mofeomolade/6S-LiPo-Buck/5V_Buck_Converter.asc

C1: cap; 2.2µF
C2: cap; 3nF
C3: cap; 0.22µ; V=50 Irms=0 Rser=0 Lser=0 mfg="Murata" pn="GCM188R71H224KA64" type="X7R"
C4: polcap; 820µ; V=35 Irms=1.045 Rser=0.081 Lser=25.9n mfg="Würth Elektronik" pn="860010578016 WCAP-ATG8 13x20" type="Al electrolytic"
C5: cap; 22µ; V=35 Irms=2.1 Rser=0.0099 Lser=3.273n mfg="Würth Elektronik" pn="870055673002 WCAP-PTHR 6,3 x 8" type="Al polymer"
C6: cap; 18nF
C7: cap; 10nF
C8: cap; 270nF
C9: cap; 1µF
D1: diode; DDZ9684
D2: schottky; MBRS360
D3: schottky; MBRS360
I1: current; 0.9ma
L2: ind; 470µ; Ipk=3.4 Rser=0.0105 Rpar=44274 Cpar=0 mfg="Coilcraft" pn="AGP4233-474"
M2: nmos; IRF530
R1: res; 10k
R2: res; 20
R3: res; 10
R4: res; 10k
R5: res; 390
R6: res; 10k
R7: res; 750
R8: res; 10k
R9: res; 10k
R10: res; 100
R11: res; 100
U1: TLC555
U2: IR2125
U4: opamp2; MCP6021
U5: opamp2; MCP6561
V2: voltage; 12V
V3: voltage; 25.2
V4: voltage; 5V
Named nets: 0, Vout, PWM, Vin, 12V, 5V, VREF, RAMP, ERR
.tran 0 40m 0 100n startup
Power Stage
.include MCP6021.txt
.include MCP6561.txt
.include DDZ9684.spice.txt
Control Stage
.options cshunt=1e-13 gshunt=1e-11 abstol=1e-7 vntol=1e-4 reltol=0.01 method=gear trtol=7
Ramp Gen
