mofeomolade/6S-LiPo-Buck/(list of files, drawings)

Other design files:
Altium/Buck.PcbDoc
Altium/Buck.SchDoc
