mofeomolade/6S-LiPo-Buck/(commit log)

2026-10-28 Clarify switching frequency description in README
    Updated the description of the switching frequency for clarity.
2026-10-28 Clarify output filter and PWM modulation details
    Updated descriptions for output filter and PWM modulation sections for clarity.
